PatrikSamuelTauchim/NX-Bluetooth-Remote/other/wiki/images/NXBluetoothRemoteSchematicsV2.1.jpg

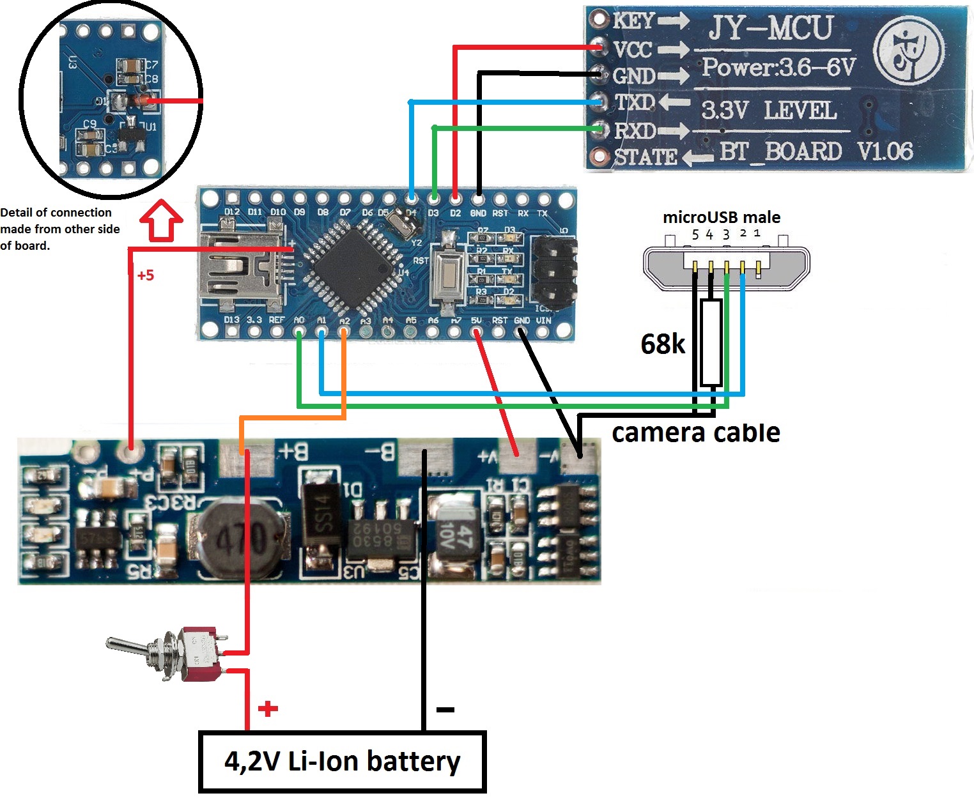
other/wiki/images/NXBluetoothRemoteSchematicsV2.1.jpg
