PatrikSamuelTauchim/NX-Bluetooth-Remote/other/wiki/images/Screenshot_2015-12-30-21-23-27.png

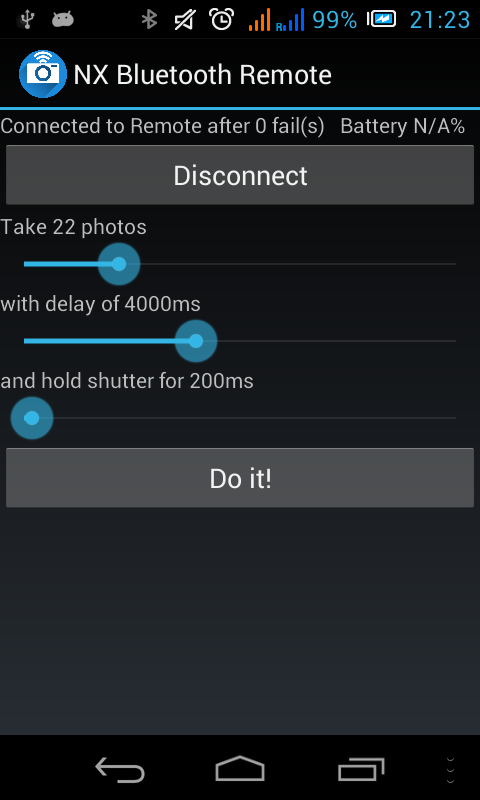
other/wiki/images/Screenshot_2015-12-30-21-23-27.png
