PatrikSamuelTauchim/NX-Bluetooth-Remote/Client software/WindowsUniversal/NXBluetoothRemote/NXBluetoothRemote/Assets/Target.scale-1600.png

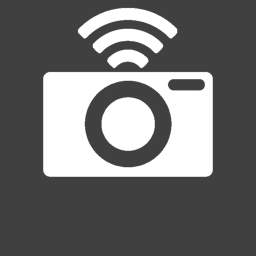
Client software/WindowsUniversal/NXBluetoothRemote/NXBluetoothRemote/Assets/Target.scale-1600.png
