PatrikSamuelTauchim/NX-Bluetooth-Remote/other/wiki/images/10199047A.jpg

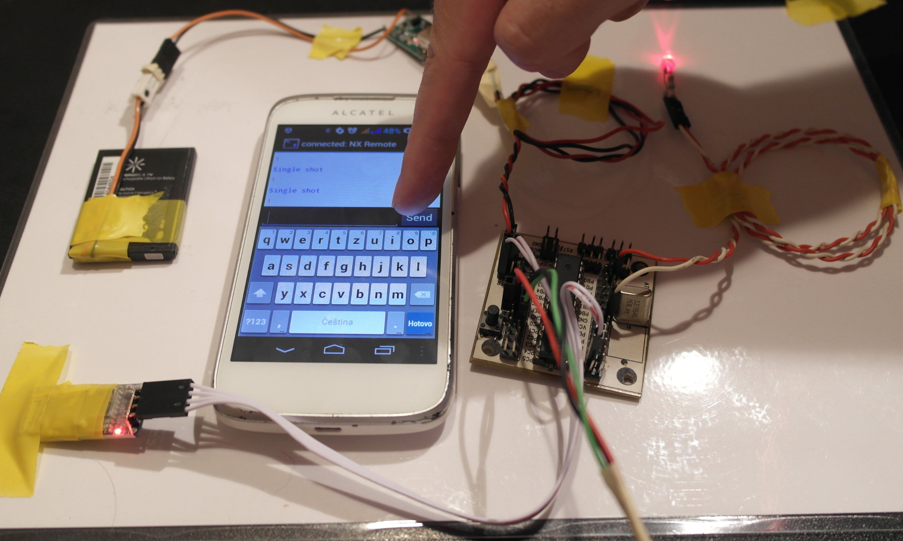
other/wiki/images/10199047A.jpg
