PatrikSamuelTauchim/NX-Bluetooth-Remote/other/wiki/images/12129008A.jpg

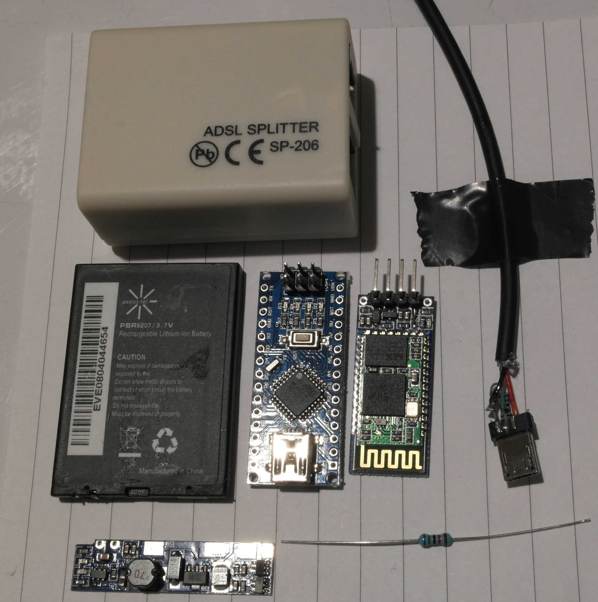
other/wiki/images/12129008A.jpg
