PatrikSamuelTauchim/NX-Bluetooth-Remote/other/wiki/images/12130039A.jpg

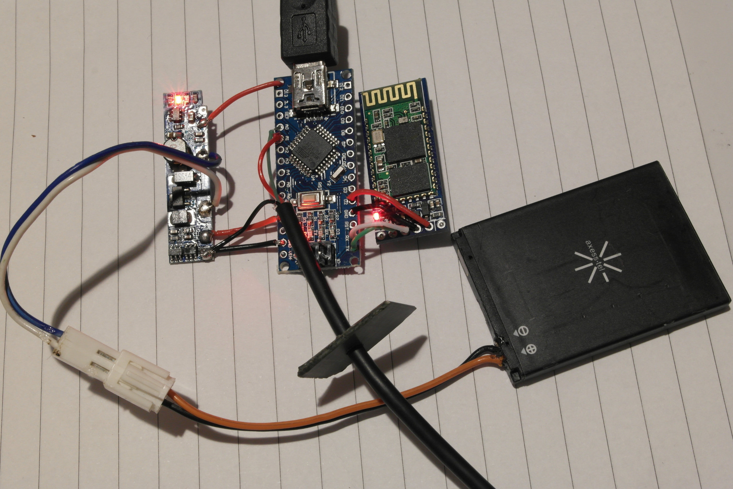
other/wiki/images/12130039A.jpg
