PatrikSamuelTauchim/NX-Bluetooth-Remote/other/wiki/images/Screenshot_2016-01-21-22-12-44.png

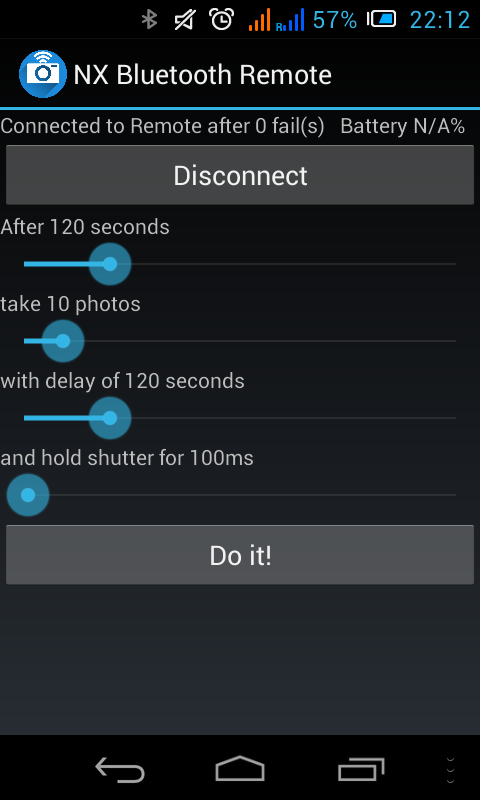
other/wiki/images/Screenshot_2016-01-21-22-12-44.png
