PatrikSamuelTauchim/NX-Bluetooth-Remote/Client software/Android/NX-Bluetooth-Remote/NXBluetoothRemote/obj/Debug/ResourceTypeUsage.txt

LinearLayout
TableLayout
TableRow
TextView
Button
SeekBar
