PatrikSamuelTauchim/NX-Bluetooth-Remote/(threads)

Thread 1 (2016-01-11):

Handle camera sleep modes

PatrikSamuelTauchim, 2016-01-11:
When display goes off, camera needs to be switched on by (half) pressing shutter before taking shot.
=> if time that past from last shot is more then display off time, wake camera before taking shot by focusing or taking shot (no shot will be taken, when display is off and camera wil just wake up => prefered?).

When camera goes to sleep mode, (max delay can be set to 30minutes), it does not accept ANY commands from remote and USB port is powered off.
=> Prevent camera from sleeping when no shot is taken for longer period of time.

PatrikSamuelTauchim, 2016-01-21:
+ 889358f  added option to set sleep delay of camera display. If set, NX Bluetooth Shutter wakes display right before each shot.

+ Long sleep, when camera is completely off, is not handled yet.
+ For now, there is no way how to configure sleep delays into NX Bluetooth Shutter externaly. Commands to change this will come soon. Variables in code are following:
```
int camDisplayOffT = 30000;      // Display goes off after 30 seconds / 30 000 miliseconds
```
```
int camSleepT = 1800;         // Camera goes to sleep after 30 minutes / 1 800 seconds (TODO/ not in use)
```

Thread 3 (2016-01-11):

Battery management and monitoring

PatrikSamuelTauchim, 2016-01-11:
Measure battery voltage at some intervals and send percentage of remaining battery charge to client application(s).

Needs additional connection between battery positive terminal and A(DC) pin to be made.

PatrikSamuelTauchim, 2016-01-13:
+  9312dcd  added connection between pin A2 and battery positive pin (after switch) to allow voltage measurement.
* Considering moving connection before switch, so battery voltage can be measured while switch is in OFF possition, while powered by external source. This could allow to user check battery charge and enable charging if necessary. Need to verify, that this will not lead to battery discharge while switch is OFF and external power not present.

PatrikSamuelTauchim, 2016-01-21:
889358f  added reporting raw value read from battery.

*  I still need to measure max and min voltage to calculate % of remaining charge.

Thread 4 (2016-01-11):

Power OFF or sleep

PatrikSamuelTauchim, 2016-01-11:
There is no way to power device off for storage and transport. Battery life during use is not problem (many hours while paired).

Power switch should be added - on positive wire between power board and power input.
* Actually looking for switch that is small enough to fit inside the box and easy to mount.

Or make software off, power saving mode, or some sleep. + some power saving
* Powering off bluetooth module will save lot of power = 20-40mA
* Remove power LED (always on) = few mA
* Remove Bluetooth LED (always on while paired/blinking while not) = few mA
* Put Arduino to sleep
* But, how to wakeup without buttons and bluetooth?
* We can check if camera is ON or OFF and if it is OFF, we can sleep.
* But, when cable is not connected, this does not work since cable is picking up noise - it is not grounded.
* Could be interesting to make female micro USB connector with pins shorted (grounded) so camera cable could be plug into it. Effect should be same like if camera is off or in sleep.

And now I go to sleep...

PatrikSamuelTauchim, 2016-01-13:
ON/OFF switch added in 9312dcd between battery+ and power module.
+ Complete power down while no external power from USB is not available.
+ While external power is available, can prevent battery from charging. This can be useful when connected to portable device which is also powered by battery to save power.

Closed 2016-01-13.
