PatrikSamuelTauchim/NX-Bluetooth-Remote/(commit log)

2015-10-25 Picture of prototype for wiki
    + 10199047A.jpg
2015-12-13 Arduino Nano 3.0
    Hacked together from tutorials, somehow works.
2015-12-13 Arduino Nano 3.0 prototype pictures
    + parts
    + finished
2015-12-30 Arduino Update + Android App
    + New command format: CSV for amount of requested photos to take, delay
    between them and shutter hold time.
    + Arduino is now capable of taking set amount of photos with set delay
    and shutter hold time.
    + New Android App allows to set parameters via simple interface and then
    send CSV command to NX Bluetooth Remote module.
    + .apk file included in debug folder - Android 4.0.3 and later required
    + Commands are accepted via USB serial port and/or software serial port,
    where bluetooth module is connected
2016-01-03 Schematics added
    + Schematics for current Arduino Nano V3 (clone) based prototype
2016-01-13 Updated schematics
    + ON/OFF switch
    + Connection to measure battery voltage
2016-01-21 Command execution delay + battery + sleep handling
    + Option to set delay before executing command #2
    + Handling display sleep - wake display right before shot
    + Reading voltage from battery - not complete yet #3
    + Debug, diagnostics and configuration added
2016-08-18 Universal Windows App
    + Universal Windows App for Windows 10 and Windows 10 Mobile
    * First publish, basic stuff works
    * For HW/Arduino: Debug messages are now also sent via bluetooth
